spaivaras/nekvailas_stalas/README.md

Nekvailas Stalas
================

- **HardwareLayer** - Code for main hardware abstraction layer interfacing all sensors
- **pcb_nfc_antenna** - A KiCad project for multiple 125KHz pcb antennas
- **rfid_reader** - 125Khz I2C Atmega8 RFID reader
- **UI design** - Web page assets
- **api** - Web api
