spaivaras/nekvailas_stalas/UI design/UI Screens/Desktop HD - Busy.png

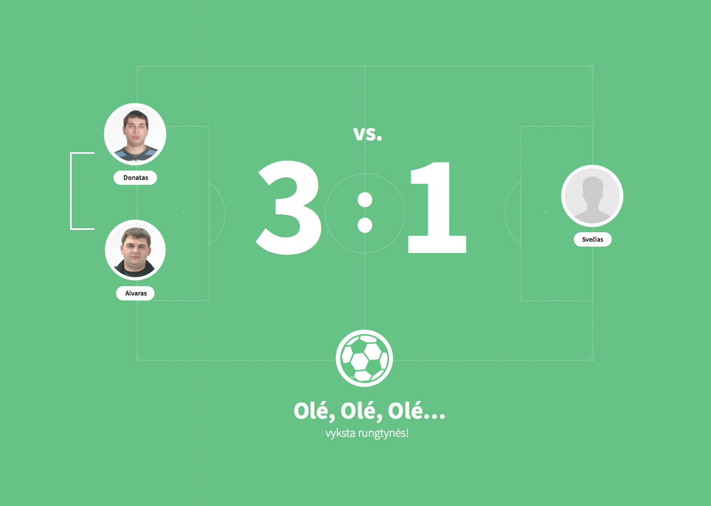
UI design/UI Screens/Desktop HD - Busy.png
