spaivaras/nekvailas_stalas/UI design/UI Screens/Desktop HD - Empty.png

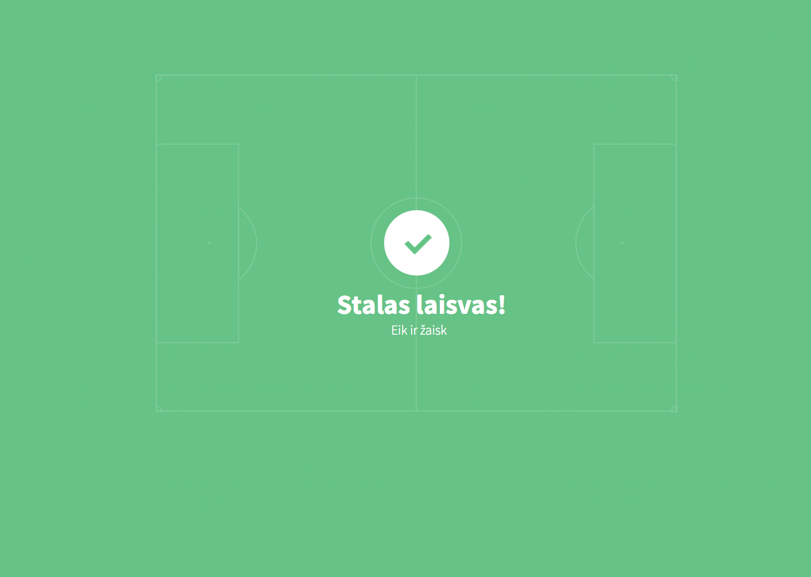
UI design/UI Screens/Desktop HD - Empty.png
