spaivaras/nekvailas_stalas/UI design/UI Screens/Desktop HD - Winners.png

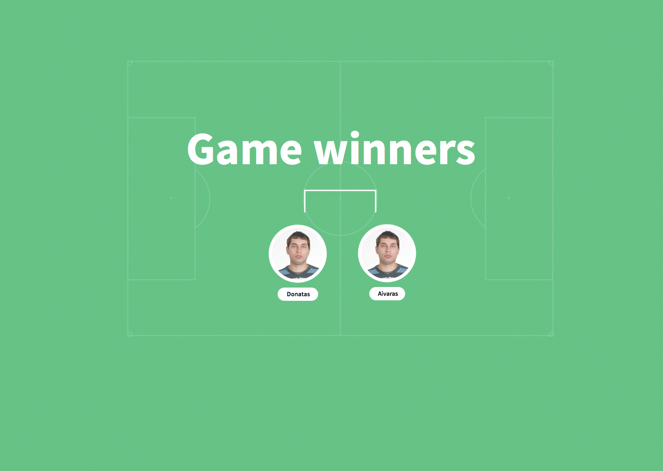
UI design/UI Screens/Desktop HD - Winners.png
