spaivaras/nekvailas_stalas/connector_board/cboard.kicad_pcb

## KiCad design connector_board/cboard.kicad_pcb (2014-04-27)

Schematic: cboard.sch

Parts:
C1, C2, C3, C4, C5: 0.1uF
D1, D2, D3, D4: ZENERSMALL
P1, P2, P3, P5, P6, P7, P8, P9, P10, P11, P22: CONN_4
P4, P12, P13, P14, P15, P16, P17, P18, P19, P20, P21, P23, P24, P25, P26, P27, P28, P29, P30: CONN_2
Q1, Q2: BS107; TO92
R1, R2, R3, R4, R5, R6, R7, R8: 1K
R9, R12, R14, R16: 10K
R10, R11, R13, R15: 120

Connections:
+3.3V: P13.1, P17.1, P21.1, P26.1, P29.1, Q1.2 (G), Q2.2 (G), R1.1, R2.1, R9.1, R10.1, R11.1, R12.1, R13.1, R14.1, R15.1, R16.1
+5V: C1.1, C2.1, C3.1, C4.1, C5.1, P12.2 (PM), P16.2 (PM), P20.2 (PM), P25.2 (PM), P28.2 (PM), R3.1, R4.1
GND: C1.2, C2.2, C3.2, C4.2, C5.2, D1.1, D2.1, D3.1, D4.1, P1.2, P2.2, P5.2, P6.2, P7.2, P8.2, P10.2, P11.2, P12.1, P13.2 (PM), P14.2 (PM), P15.2 (PM), P16.1, P17.2 (PM), P18.2 (PM), P19.2 (PM), P20.1, P21.2 (PM), P23.2 (PM), P24.2 (PM), P25.1, P26.2 (PM), P27.2 (PM), P28.1, P29.2 (PM), P30.2 (PM)
unnamed: P3.1, P6.4
unnamed: P3.2, P5.4
unnamed: P2.4, P3.3
unnamed: P15.1, R10.2
unnamed: P1.4, P3.4
unnamed: P22.1, P30.1, R16.2
unnamed: P19.1, P22.3, R12.2
unnamed: P22.2, P24.1, R14.2
unnamed: P14.1, P22.4, R9.2
unnamed: P27.1, R15.2
unnamed: P23.1, R13.2
unnamed: P18.1, R11.2
unnamed: P7.3, P8.3, P10.3, P11.3, Q2.1 (D), R4.2
unnamed: P7.1, P8.1, P10.1, P11.1, Q1.1 (D), R3.2
unnamed: P1.1, P2.1, P4.2 (PM), P5.1, P6.1, Q1.3 (S), R1.2
unnamed: P1.3, P2.3, P4.1, P5.3, P6.3, Q2.3 (S), R2.2
unnamed: P11.4, R8.1
unnamed: P10.4, R7.1
unnamed: P8.4, R6.1
unnamed: D4.2, P9.1, R8.2
unnamed: D3.2, P9.2, R7.2
unnamed: D2.2, P9.3, R6.2
unnamed: D1.2, P9.4, R5.2
unnamed: P7.4, R5.1

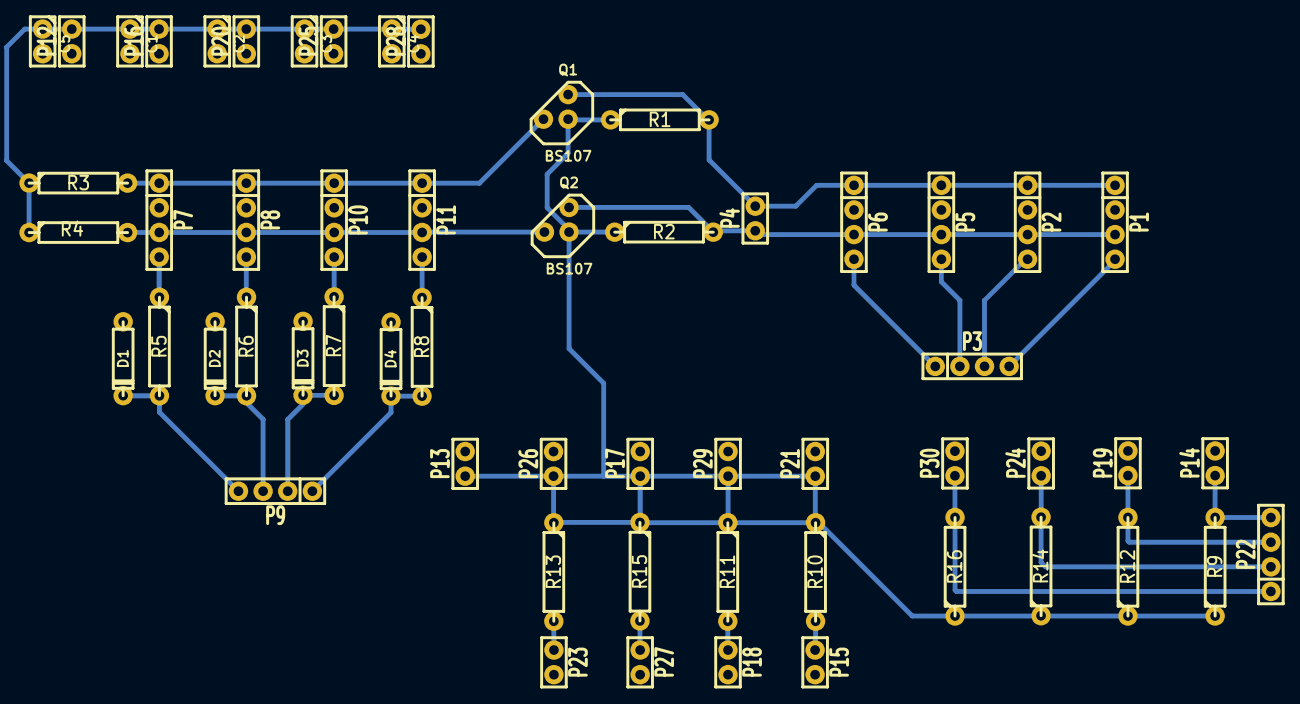
[picture p5: board cboard.kicad_pcb from above]

Board: 2 copper layers, 57 parts (0 on the bottom side), 27 nets.
