spaivaras/nekvailas_stalas/rfid_reader/pcb/rfid.kicad_pcb

## KiCad design rfid_reader/pcb/rfid.kicad_pcb (2014-04-21)

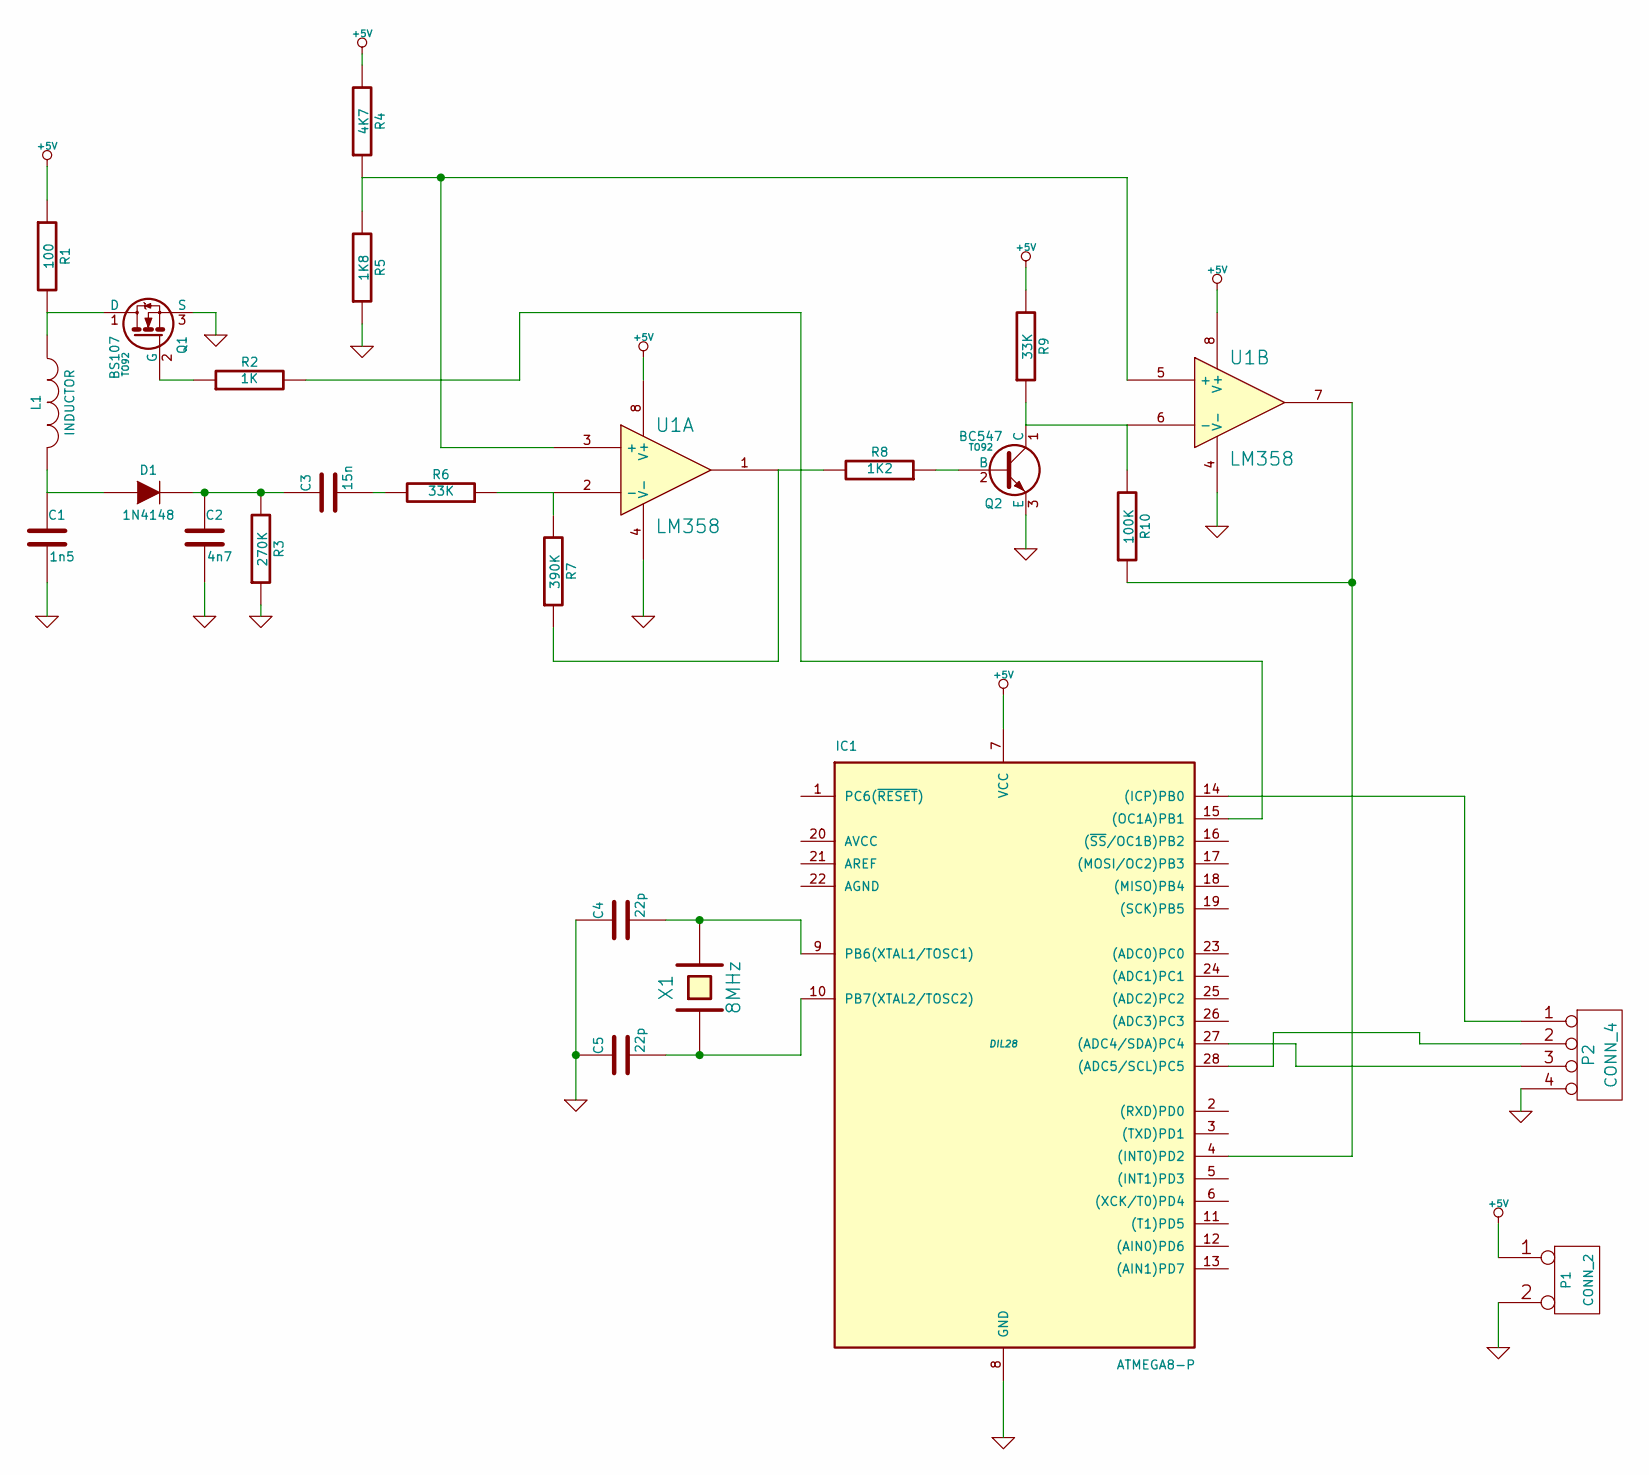
[picture p6: schematic rfid.sch]

Parts:
C1: 1n5
C2: 4n7
C3: 15n
C4, C5: 22p
D1: 1N4148
IC1: ATMEGA8-P; DIL28
L1: INDUCTOR
P1: CONN_2
P2: CONN_4
Q1: BS107; TO92
Q2: BC547; TO92
R1: 100
R2: 1K
R3: 270K
R4: 4K7
R5: 1K8
R6, R9: 33K
R7: 390K
R8: 1K2
R10: 100K
U1: LM358
X1: 8MHz

Connections:
+5V: IC1.7 (VCC), P1.1, R1.1, R4.2, R9.2, U1.8 (V+)
GND: C1.2, C2.2, C4.1, C5.1, IC1.8 (GND), P1.2 (PM), P2.4, Q1.3 (S), Q2.3 (E), R3.1, R5.1, U1.4 (V-)
unnamed: Q2.1 (C), R9.1, R10.2, U1.6 (-)
unnamed: IC1.4 ((INT0)PD2), R10.1, U1.7
unnamed: C5.2, IC1.10 (PB7(XTAL2/TOSC2)), X1.1
unnamed: C4.2, IC1.9 (PB6(XTAL1/TOSC1)), X1.2
unnamed: R4.1, R5.2, U1.3 (+), U1.5 (+)
unnamed: Q2.2 (B), R8.1
unnamed: R7.1, R8.2, U1.1
unnamed: IC1.14 ((ICP)PB0), P2.1
unnamed: IC1.27 ((ADC4/SDA)PC4), P2.3
unnamed: IC1.28 ((ADC5/SCL)PC5), P2.2
unnamed: IC1.15 ((OC1A)PB1), R2.2
unnamed: C3.2, R6.2
unnamed: R6.1, R7.2, U1.2 (-)
unnamed: L1.1, Q1.1 (D), R1.2
unnamed: Q1.2 (G), R2.1
unnamed: C1.1, D1.1 (A), L1.2
unnamed: C2.1, C3.1, D1.2 (K), R3.2

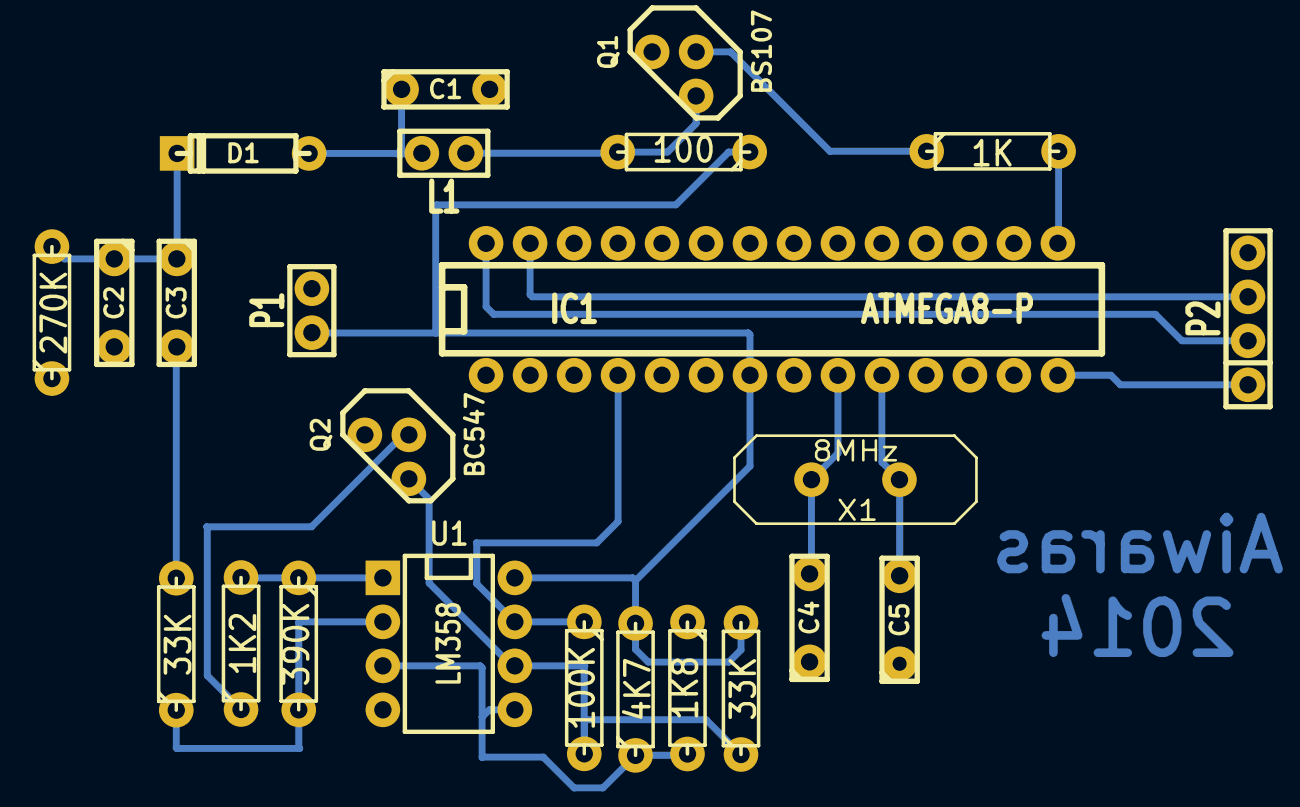
[picture p7: board rfid.kicad_pcb from above]

Board: 2 copper layers, 24 parts (0 on the bottom side), 19 nets.
