spaivaras/nekvailas_stalas/connector_board/cboard.sch

## KiCad design connector_board/cboard.sch (2014-04-27)

Schematic: cboard.sch

Parts:
C1, C2, C3, C4, C5: 0.1uF
D1, D2, D3, D4: ZENERSMALL
P1, P2, P3, P5, P6, P7, P8, P9, P10, P11, P22: CONN_4
P4, P12, P13, P14, P15, P16, P17, P18, P19, P20, P21, P23, P24, P25, P26, P27, P28, P29, P30: CONN_2
Q1, Q2: BS107; TO92
R1, R2, R3, R4, R5, R6, R7, R8: 1K
R9, R12, R14, R16: 10K
R10, R11, R13, R15: 120
