spaivaras/nekvailas_stalas/pcb_nfc_antenna/pcb_nfc_antenna.sch

## KiCad design pcb_nfc_antenna/pcb_nfc_antenna.sch (2014-04-15)

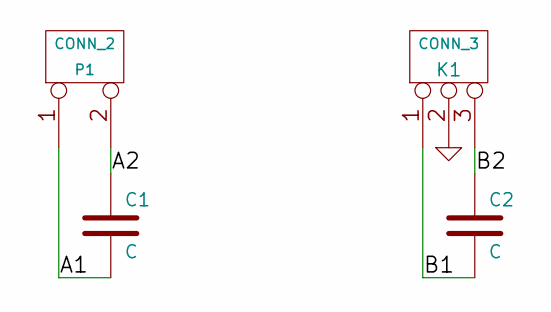
[picture p8: schematic pcb_nfc_antenna.sch]

Parts:
C1, C2: C
K1: CONN_3
P1: CONN_2

Connections:
A1: C1.2, P1.1
A2: C1.1, P1.2 (PM)
B1: C2.2, K1.1
B2: C2.1, K1.3
GND: K1.2 (PM)
