spaivaras/nekvailas_stalas/HardwareLayer/sleep.cpp

#include <time.h>
#include "sleep.h"

int nsleep(long ns) {
	struct timespec req={0};
	time_t sec=(int)(ns/1000000000L);
	ns=ns-(sec*1000000000L);
	req.tv_sec=sec;
	req.tv_nsec=ns;
	return nanosleep(&req, NULL);
}

int usleep(long us) {
	return nsleep(us*1000);
}

int msleep(long ms) {
	return nsleep(ms*1000*1000);
}

int sleep(long s) {
	struct timespec req={0};
	req.tv_sec=s;
	req.tv_nsec=0;
	return nanosleep(&req, NULL);
}
