spaivaras/nekvailas_stalas/(commit log)

2014-04-15 adding gitignore with rules for kicad project
2014-04-15 adding two types of pcb antenna for RFID reader
    [pcb_nfc_antenna.brd, pcb_nfc_antenna.sch]
2014-04-15 RFID reader initial commit
    [rfid.kicad_pcb, rfid.sch]
2014-04-21 Added I2C to PSB
    [rfid.kicad_pcb, rfid.sch]
2014-04-23 Updating source for I2C support
2014-04-26 adding events pusher on a separate thread
2014-04-27 Bug, unhandled i2c interrupt is streaching SCL
    [RFID.c]
2014-04-27 Adding fatherboard
    [cboard.kicad_pcb, cboard.sch]
2014-04-28 adding content-type http header, fixes #10
    [EventsPusher.cpp]
2014-04-30 Adding gyro implementation, small changes
2014-05-01 adding psiaudocode for morse encoder/sender with user callback
2014-05-03 adding logger to wrap around syslog and printf
2014-05-03 using wrapper macros for logging instead of plain printf()s
